speleoalex/opsdatalogger/README.md

# FluxyLogger

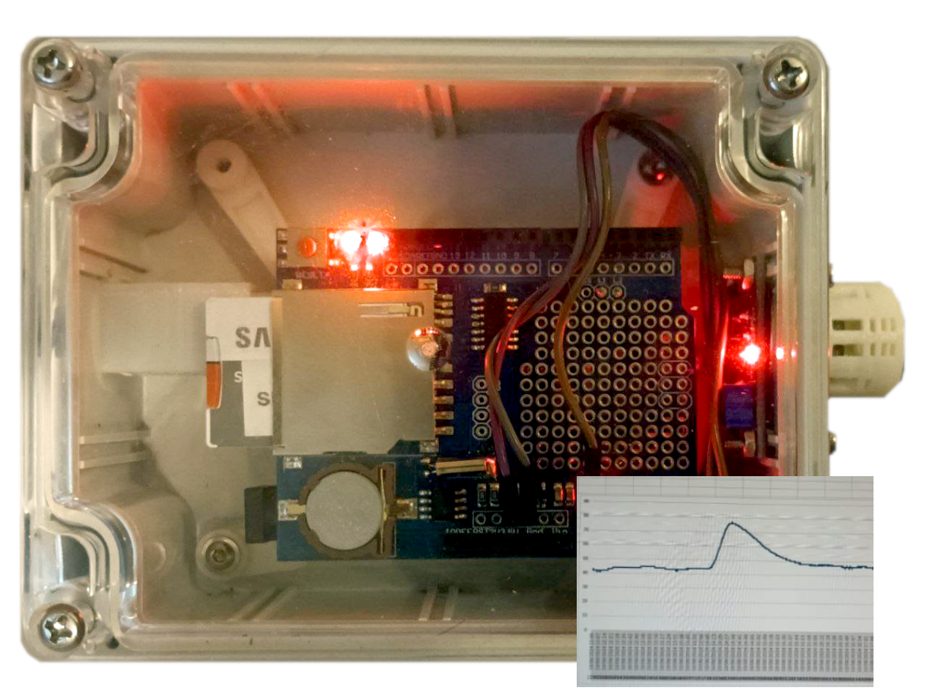
[picture p1: Naso.png]
FluxyLogger


**FluxyLogger** is an open source modular datalogger platform based on Arduino UNO for environmental monitoring, originally developed for cave air tracing studies.

## 🎯 Quick Start

**New here?** Start with the Platform Overview to understand available configurations:

- 📘 [**Platform Overview (English)**](FluxyLogger-Platform-Overview-en.md)
- 📘 [**Panoramica Piattaforma (Italiano)**](FluxyLogger-Platform-Overview-it.md)

## 📦 Available Configurations

FluxyLogger can be configured for different applications:

| Configuration | Sensors | Use Case | Status | Documentation |
|---|---|---|---|---|
| 🌬️ **NASO** | MQ-2 | Air tracing in caves | ✅ Ready | [IT](manuals/FluxyLogger-NASO-it.md) \| [EN](manuals/FluxyLogger-NASO-en.md) |
| 📱 **NASO + LCD** | MQ-2 + Display | Air tracing with real-time display | ✅ Ready | [IT](manuals/FluxyLogger-NASO_lcd-it.md) \| [EN](manuals/FluxyLogger-NASO_lcd-en.md) |
| 🌤️ **METEO** | BMP280 + Anemometer | Weather station (pressure, temp, wind) | ✅ Firmware ready | [IT](doc/assembly/METEO_VOC_assembly_guide_it.md) \| [EN](doc/assembly/METEO_VOC_assembly_guide_en.md) |
| 🏭 **VOC** | SGP40/SGP30 | Air quality monitoring (VOC index) | ✅ Firmware ready | [IT](doc/assembly/METEO_VOC_assembly_guide_it.md) \| [EN](doc/assembly/METEO_VOC_assembly_guide_en.md) |

**Note**: METEO and VOC firmware support is complete (v2.45) but requires enabling sensors in code - see assembly guides for details.

**Purchase**: Assembled NASO units available at [TechMakers](https://techmakers.eu/products/new-cave-monitoring-n-a-s-o-datalogger-for-atmospheric-tracer-tracking-assembled)

## 🔧 Base Components

All configurations share:

- Arduino UNO (or WiFi R4)
- Data Logger Shield with RTC
- MicroSD Card
- USB PowerBank
- Enclosure box
- Connection wires

[Full component list](doc/components.md)

## 📖 Documentation

### User Guides

- [Platform Overview IT](FluxyLogger-Platform-Overview-it.md) - Panoramica completa delle configurazioni
- [Platform Overview EN](FluxyLogger-Platform-Overview-en.md) - Complete configuration overview
- [NASO Manual IT](manuals/FluxyLogger-NASO-it.md) - Manuale utente configurazione NASO
- [NASO Manual EN](manuals/FluxyLogger-NASO-en.md) - NASO configuration user manual
- [Update Firmware IT](manuals/UpdateFirmware_it.md) - Aggiornamento firmware
- [Project History IT](Progetto_Fluxylogger_NASO.md) - Storia del progetto

### Assembly Guides

- [NASO Assembly IT](doc/assembly/NASO_assembly_complete_guide_it.md) - Guida assemblaggio NASO e NASO+LCD
- [NASO Assembly EN](doc/assembly/NASO_assembly_complete_guide_en.md) - NASO and NASO+LCD assembly guide
- [METEO/VOC Assembly IT](doc/assembly/METEO_VOC_assembly_guide_it.md) - Guida assemblaggio METEO e VOC
- [METEO/VOC Assembly EN](doc/assembly/METEO_VOC_assembly_guide_en.md) - METEO and VOC assembly guide

### Technical Documentation

- [Wiring Diagrams](doc/wiring/) - Connection schematics for all sensors
- [Source Code](FluxyLogger/FluxyLogger.ino) - Arduino firmware (v2.45)
- [CAD Files](drawings/) - 3D models and enclosure drawings
- [Technical Docs](doc/) - Datasheets, presentations, and technical resources

### Software Tools

- [LoggerViewer Web App](https://applications.techmakers.it/datalogger/loggermanager.htm) - Browser-based data viewer
- [LoggerViewer Desktop](LoggerViewer_Desktop/README.md) - Cross-platform desktop application
- [AI Assistant](https://www.sparkilla.com/application/NASO4CAVE) - Virtual assistant for log analysis

## 💾 Data Format

All configurations save data to microSD as CSV files with timestamps:

**NASO (Gas Detection):**

```csv
date Y-m-d H:M:S;gas adc;LPG PPM
2023-11-17 17:16:02;80;0
2023-11-17 17:17:02;125;45
```

**METEO (Weather Station):**

```csv
date Y-m-d H:M:S;temperature_C;pressure_hPa;altitude_m;wind_speed_ms
2025-01-24 12:30:00;15.2;1013.5;450;2.3
```

**VOC (Air Quality):**

```csv
date Y-m-d H:M:S;voc_index;tvoc_ppb;temperature_C;humidity_RH
2025-01-24 12:30:00;125;450;22.5;55
```

Measurement interval configurable via CONFIG.INI or USB connection.

## 🌍 Community & Support

- **Telegram Group**: [https://t.me/+u5CoELQNjC1iODZk](https://t.me/+u5CoELQNjC1iODZk)
- **GitHub**: [https://github.com/speleoalex/fluxylogger](https://github.com/speleoalex/fluxylogger)
- **Issues**: Report bugs and request features on GitHub Issues

### Support the Project

If you find this project useful, consider supporting its development:

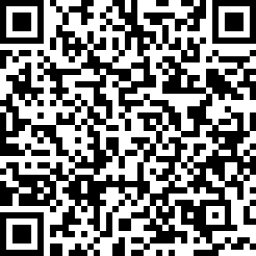
[picture p2: paypal.png]
Donate with PayPal (https://www.paypal.com/donate/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)


## 📜 License & Credits

- **License**: GNU General Public License
- **Author**: Alessandro Vernassa (speleoalex@gmail.com)
- **Website**: <https://techmakers.it/un-naso-per-gli-speleologi.html/>
- **Firmware Version**: 2.45
- **Started**: 2020

---

**Quick Links**: [Platform Overview](FluxyLogger-Platform-Overview-en.md) | [NASO Manual](manuals/FluxyLogger-NASO-en.md) | [Firmware Update](manuals/UpdateFirmware_it.md) | [Components](doc/components.md)
