speleoalex/opsdatalogger/doc/README.md

# Technical Documentation

Documentazione tecnica del progetto FluxyLogger.

## Struttura Directory

### 📁 [datasheets/](datasheets/)
Datasheet e manuali tecnici dei componenti:
- Sensori (MQ-2, MQ-6, SGP40, BMP280)
- Moduli e shield
- Documentazione in PDF

### 📁 [wiring/](wiring/)
Schemi di collegamento elettrico:
- `connections_MQ2_NASO.png` - Schema MQ-2
- `connections_lcd.png` - Schema LCD I2C
- `connections_LCD_LCM1602_I2C_version.png` - Schema LCD alternativo
- `connections_bmp280.png` - Schema BMP280
- `connections_sgp40.png` - Schema SGP40
- `connections_wind.png` - Schema Wind Sensor

### 📁 [assembly/](assembly/)

Assembly and testing guides:

**Italian (IT):**

- [NASO_assembly_complete_guide_it.md](assembly/NASO_assembly_complete_guide_it.md) - Complete NASO and NASO+LCD assembly and testing guide
- [METEO_VOC_assembly_guide_it.md](assembly/METEO_VOC_assembly_guide_it.md) - METEO and VOC assembly and testing guide

**English (EN):**

- [NASO_assembly_complete_guide_en.md](assembly/NASO_assembly_complete_guide_en.md) - Complete NASO and NASO+LCD assembly and testing guide
- [METEO_VOC_assembly_guide_en.md](assembly/METEO_VOC_assembly_guide_en.md) - METEO and VOC assembly and testing guide

### 📁 [presentations/](presentations/)
Materiale di presentazione del progetto

### 📁 [tracers/](tracers/)
Documentazione sui traccianti atmosferici

## File nella Root

- `components.md` - Lista completa componenti hardware
- Immagini varie per documentazione

## Collegamenti Utili

- [Lista Componenti](components.md)
- [Schemi CAD](../drawings/)
- [Manuali Utente](../manuals/)
