speleoalex/opsdatalogger/example_logs/log_Finale_Ligure_Perti/2025_06_29_giugno_Pollera/Relazione_NASO_Pollera_29_giugno_2025.pdf

# Tracciamento 29 giugno 2025 Arma della Pollera

Il 28 giugno, alle ore 13:45, abbiamo effettuato un tracciamento utilizzando quattro bombolette di aria compressa da 400 ml, immesse sul fondo dello scivolo della grotta Pollera.
La temperatura esterna era di 30 gradi.
I sensori N.A.S.O. sono stati posizionati all’ingresso dell’Arma della Pollera, uno a destra e uno a sinistra dello scivolo, nonché nell’Arma do Rian, sia prima che dopo la strettoia e all’Arma della Puzzanghera a circa metà grotta..
Non è stato possibile disporre di termometri per rilevare la temperatura interna.

## Risultati tracciamento

Grotta del Rian interno:
Positivo dalle 14:20 con picco 18:33

Grotta del Rian esterno:
Positivo dalle 14:50 con picco 18:33

Garbu du Surdu
Positivo dalle 15:20 con picco alle 22:09

Arma della Pozzanghera
Negativo

## Grafici

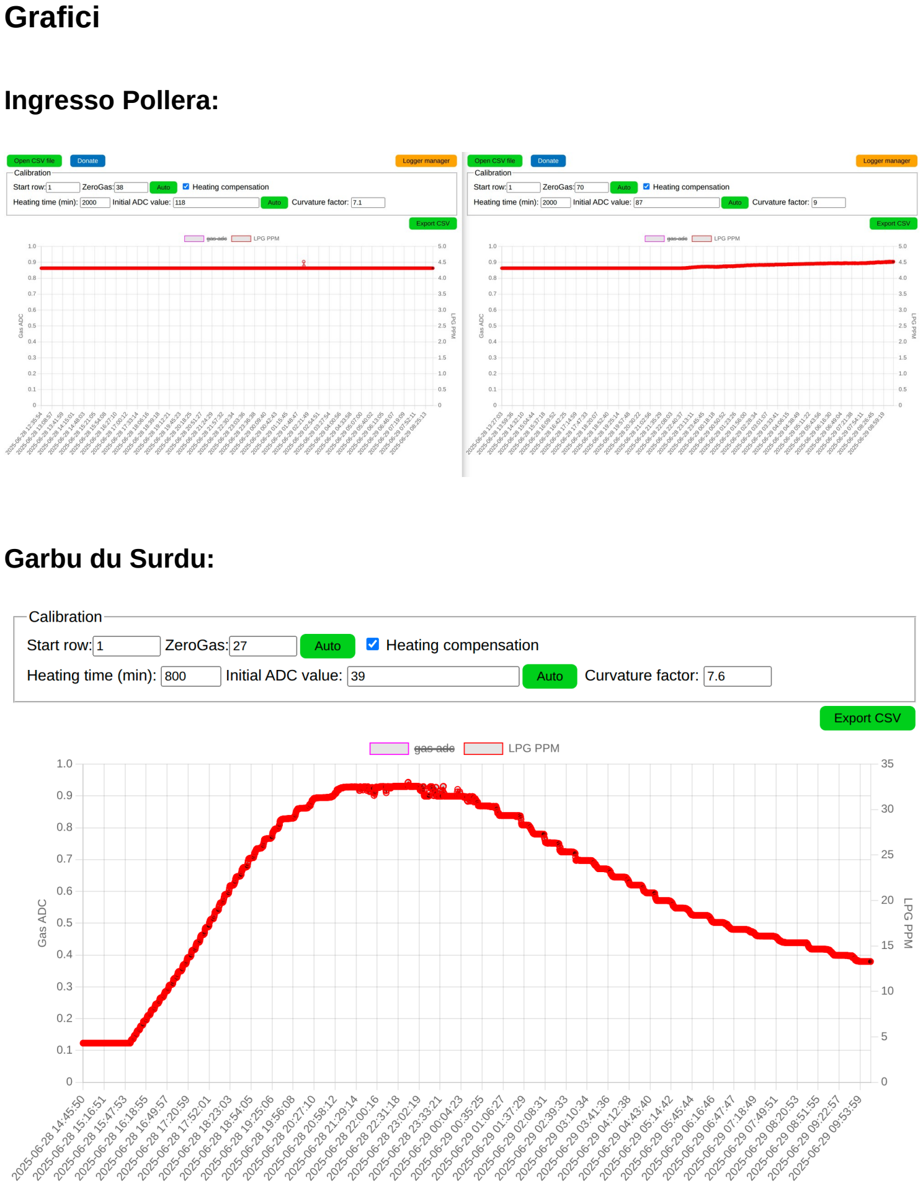
[picture p7: page 2]

Ingresso Pollera:

Garbu du Surdu:

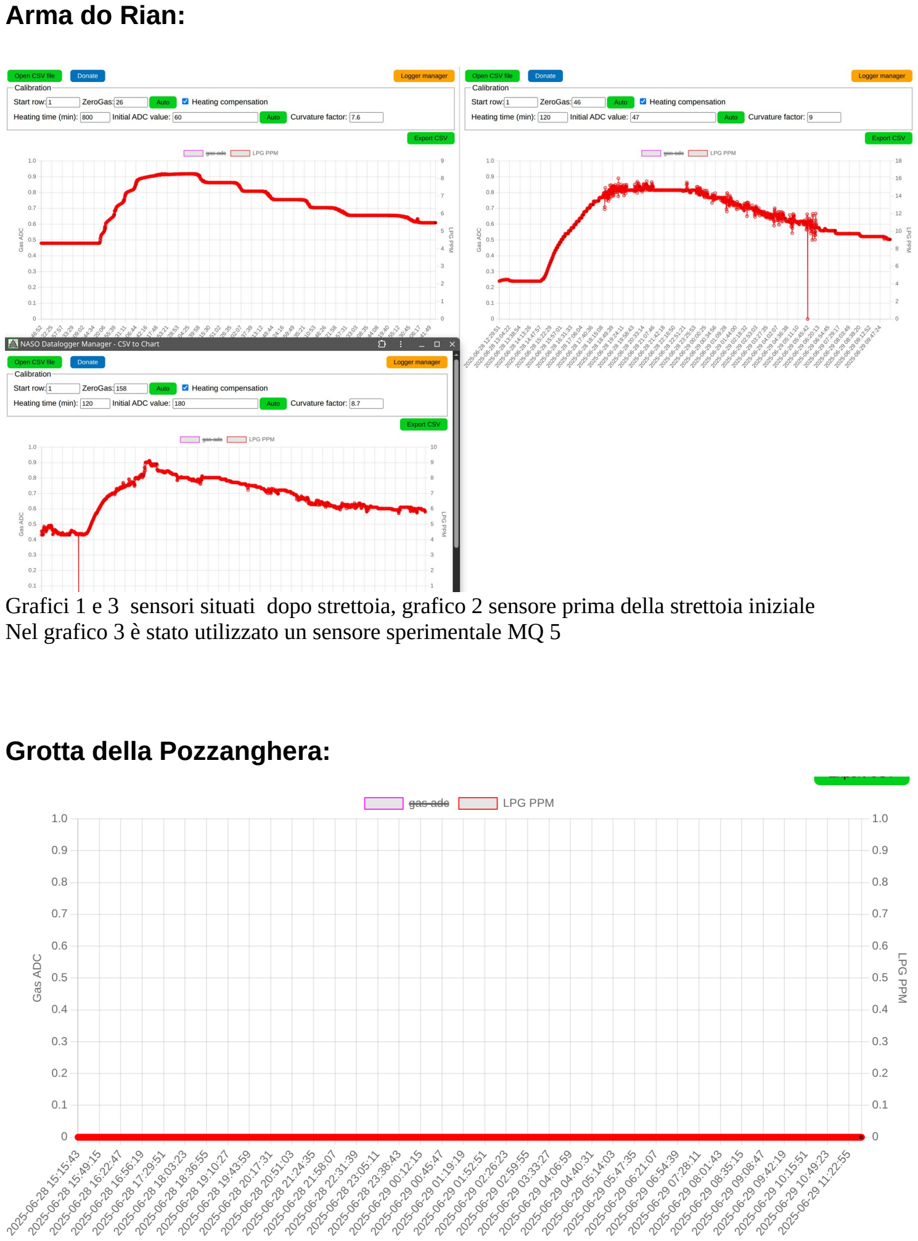
[picture p8: page 3]

Arma do Rian:

Grafici 1 e 3 sensori situati dopo strettoia, grafico 2 sensore prima della strettoia iniziale Nel grafico 3 è stato utilizzato un sensore sperimentale MQ 5

Grotta della Pozzanghera:
