speleoalex/opsdatalogger/doc/tracers/Tracer_dispersion_IT.md

# Dispersione di traccianti artificiali in grotte ventilate

**Autori:** Claudio Pastore, Eric Weber, Frédéric Doumenc, Pierre-Yves Jeannin, Marc Luetscher

**Pubblicato su:** International Journal of Speleology, 53(1), 51-62, Gennaio 2024

**DOI:** https://doi.org/10.5038/1827-806X.53.1.2497

---

## Abstract

La CO2 artificiale è stata utilizzata come tracciante lungo condotti carsici ventilati per dedurre il flusso d'aria e investigare la dispersione del tracciante. Nella zona vadosa carsica, la ventilazione delle grotte è un modo efficiente di trasporto per calore, gas e aerosol e quindi guida la distribuzione spaziale delle particelle trasportate dall'aria. La modellizzazione di questo trasporto aereo richiede parametri geometrici e fisici del sistema di condotti, incluse le sezioni trasversali, il flusso d'aria e la velocità media dell'aria, così come il coefficiente di dispersione longitudinale che descrive la diffusione di un soluto.

Quattro test di tracciamento sono stati effettuati in una miniera (condotto artificiale) e due grotte ventilate (condotti naturali). In questo articolo, dimostriamo che è possibile ottenere tassi di flusso d'aria affidabili e informazioni geometriche di condotti carsici ventilati utilizzando la CO2 come tracciante. Il flusso d'aria è stato misurato lungo due grotte e una miniera e confrontato con misurazioni puntuali effettuate con un anemometro a filo caldo. Le sezioni trasversali stimate con i test di CO2 sono state confrontate con quelle misurate in situ.

Inoltre, l'analisi delle curve di breakthrough (BTC) ha mostrato un accentuato effetto coda lungo i condotti naturali investigati a causa della presenza di singolarità dispersive che possibilmente permettono la deposizione di aerosol. La lunga coda osservata nelle grotte di Milandre e Longeaigue è probabilmente dovuta a variazioni di sezione trasversale. Un modello di avvezione-dispersione 1-D testato per questi siti non è stato in grado di adattarsi all'effetto coda delle BTC nei condotti naturali.

Nel condotto artificiale di Baulmes, dove non si osserva una lunga coda, il coefficiente di dispersione è stato stimato utilizzando il metodo di Chatwin e confrontato con la previsione della teoria di Taylor. Nonostante la geometria regolare della miniera di Baulmes, la correlazione di Taylor sottostima significativamente il coefficiente di dispersione dedotto dai dati di campo, mostrando la necessità di ulteriori lavori teorici sulla dispersione turbolenta nelle miniere.

Questo articolo fornisce una prima panoramica sul movimento dell'aria e sulla dispersione della materia lungo condotti carsici ventilati, preparando una corretta modellizzazione della dispersione degli aerosol.

**Parole chiave:** ventilazione carsica, effetto camino, flusso d'aria, CO2, test di tracciamento

---

## 1. INTRODUZIONE

Nella zona vadosa carsica, la ventilazione delle grotte è un modo efficiente di trasporto per calore, gas e aerosol e quindi guida la distribuzione spaziale delle particelle trasportate dall'aria. La modellizzazione di questo trasporto aereo richiede parametri geometrici e fisici del sistema di condotti, incluse le sezioni trasversali, il flusso d'aria e la velocità media dell'aria, così come i processi di dispersione che descrivono la diffusione della sostanza trasportata.

I parametri geometrici e la velocità dell'aria possono talvolta essere misurati sul campo, ma le imprecisioni derivano da misurazioni puntuali che possono riflettere male la velocità media dell'aria lungo i condotti. Anche il dimensionamento delle sezioni trasversali è soggetto ad approssimazioni quando estratto da un rilievo di grotta. Pertanto, sarebbe auspicabile un metodo che possa fornire informazioni sulla geometria del condotto in modo sicuro, economico e affidabile.

Il tracciamento dell'aria è stato ampiamente utilizzato nell'ingegneria mineraria per dedurre il trasporto di polvere e contaminanti nel tempo e nello spazio lungo i canali per prevenire danni alla salute degli operatori minerari dal rilascio di fumo e fumi di miniera. Tuttavia, è stato applicato solo raramente alla dinamica dell'aria nei sistemi naturali di grotte che differiscono dalle miniere a causa delle loro morfologie più complesse.

La letteratura speleologica sul tracciamento dell'aria in grotta è scarsa sebbene siano stati riportati diversi tentativi, ad esempio con CO2 iniettata, SF6 e CCl2F2, così come utilizzando traccianti naturali o flusso d'aria indotto artificialmente. La maggior parte degli studi mirava a ottenere informazioni su ingressi/uscite d'aria o tassi di flusso d'aria, ma nessuno di questi ha tentato di derivare informazioni geometriche sulla rete di condotti né la dispersione del tracciante lungo condotti naturali.

In questo articolo, dimostriamo che è possibile ottenere tassi di flusso d'aria affidabili e informazioni geometriche utilizzando la CO2 come tracciante aereo. Come per gli studi idro(geo)logici, i tassi di flusso e i parametri geometrici dei condotti possono essere derivati dalle informazioni fornite dalla curva di breakthrough (BTC) del tracciante. Inoltre, dimostriamo che nella geometria abbastanza regolare di una miniera, è possibile valutare il coefficiente di dispersione D utilizzando il metodo di Chatwin, comunemente usato in idrogeologia. Infine, suggeriamo che la coda osservata con CO2 nelle grotte con geometria complessa potrebbe essere causata dalle stesse singolarità che causerebbero la deposizione di aerosol.

---

## 2. METODI

### 2.1 Descrizione dei Siti

Quattro test di tracciamento con CO2 sono stati effettuati in una miniera ventilata naturalmente (condotto artificiale, Miniera di Baulmes) e due grotte ventilate (condotti naturali, grotte di Milandre e Longeaigue). Questi condotti sono soggetti a un effetto camino e tre dei quattro test sono stati effettuati durante un regime di ventilazione ascendente (con Tsistema > Test), mentre uno è stato eseguito durante un regime di ventilazione discendente (Tsistema < Test).

#### Miniera di Baulmes

La Miniera di Baulmes (46°47'33'' N 6°31'35'' E, 655 m s.l.m.) è stata sfruttata durante la prima metà del XX secolo per la produzione di calce e cemento. La miniera inferiore comprende 7 livelli sub-orizzontali con una lunghezza cumulata di circa 10,7 km. La differenza di elevazione tra gli ingressi inferiore e superiore raggiunge 90 m, garantendo un forte effetto camino.

Il Tunnel #10 dà accesso al livello più basso della miniera con un condotto sub-orizzontale lungo 360 m che raggiunge la rete principale della miniera. La geometria è tipica di un tunnel minerario: terreno piatto (eccetto alcuni crolli locali), pareti verticali e un soffitto a volta a botte. Non si osservano ingressi o uscite d'aria lungo il Tunnel #10, eccetto per l'ingresso principale.

Tre data logger di CO2 sono stati posizionati a diverse stazioni: per il test durante il regime ascendente a 128 m (St_B3), 280 m (St_B4) e 360 m (St_B5) dall'ingresso inferiore; a 232 m (St_B3), 270 m (St_B2) e 360 m (St_B1) per il test durante il regime discendente.

#### Grotta di Milandre

La Grotta di Milandre (47°29'6'' N 7°0'58'' E, 402 m s.l.m.), lunga 10,5 km, si trova nella Svizzera settentrionale su un altopiano calcareo a un'elevazione di circa 500 m s.l.m. I principali passaggi del fiume sotterraneo cumulano 4,6 km tra gli ingressi superiore e inferiore (135 m di differenza di elevazione). La grotta è conforme all'effetto camino, garantendo una ventilazione permanente (discendente o ascendente, a seconda della temperatura esterna).

Il test di tracciamento con CO2 è stato effettuato in un transetto lungo 90 m nella parte inferiore della grotta. Due stazioni di misurazione sono state posizionate rispettivamente a 20 m (Mil_20) e 90 m (Mil_90 m) dal punto di rilascio della CO2.

#### Grotta di Longeaigue

La Grotta di Longeaigue si trova in Val-de-Travers (Ingresso superiore: 46°52′22″ N 6°31′09″ E, 917 m s.l.m.; Ingresso inferiore: 46°52′18″ N 6°31′09″ E, 820 m s.l.m.) e si sviluppa per 1,3 km. È principalmente asciutta ed è attraversata da un intenso flusso d'aria dovuto all'effetto camino che si sviluppa tra i due ingressi. La differenza di elevazione è di 90 m con una distanza di ~300 m tra i due ingressi.

Il test di CO2 è stato effettuato lungo il passaggio principale, rilasciando il gas vicino all'ingresso inferiore e monitorando il breakthrough del gas a 3 stazioni: Lo_239 (239 m dal punto di iniezione), Lo_278 (278 m dal punto di iniezione) e Lo_294 (294 m dal punto di iniezione).

La grotta è abbastanza grande fino a ~237 m, con estese gallerie sub-orizzontali freatiche che mostrano alcune morfologie di rimodellamento vadoso (pozzi), e diventa più stretta nella parte superiore dove la grotta ha condotti di compressione. Tra le stazioni Lo_294 e Lo_278 è presente un passaggio secondario della grotta che può causare cadute di flusso d'aria in questa sezione della grotta.

### 2.2 Confronto tra i Tre Siti

Sono state rilevate ventotto sezioni trasversali a Baulmes, 10 a Milandre e 30 a Longeaigue. Per tutti tranne i primi 50 metri, la forma del tunnel di Baulmes è abbastanza omogenea, mostrando una bassa deviazione standard. Nei primi 128 m del tunnel, la media della sezione trasversale è 6,4 ± 1,8 m² (n = 13) e dall'ingresso alla seconda stazione a 280 m è 6,3 ± 1,3 m² (n = 29). Lungo l'intero tunnel di 360 m la sezione trasversale media è 6,6 ± 1,4 m² (n = 37).

Nella Grotta di Milandre, la media della sezione trasversale dei primi 20 m (Mil_20) è 10,8 ± 6,6 m² (n = 3), mentre l'intero condotto di 90 m (Mil_90) ha una sezione trasversale media di 6,3 ± 4,9 m² (n = 10).

Nella Grotta di Longeaigue, la sezione trasversale media rilevata dal punto di iniezione alla prima stazione (Lo_239) è 7,4 m² ± 4,2 (n = 25), alla seconda stazione (Lo_278) di 7,0 ± 4,3 m² (n = 27) e all'ultima stazione (Lo_294) di 6,7 ± 4,3 m² (n = 29).

La deviazione standard delle sezioni trasversali medie rende possibile affermare che i condotti naturali di Longeaigue e Milandre hanno una distribuzione meno uniforme delle sezioni trasversali su una distanza minore rispetto al tunnel antropico di Baulmes e che le variazioni di sezione trasversale in Baulmes sono meno pronunciate che in Longeaigue e Milandre.

### 2.3 Strumentazione

È stato utilizzato un serbatoio di 1,5 kg di CO2 (2 L, 5,7·10³ kPa) per rilasciare il tracciante. Il serbatoio era dotato di una valvola a rubinetto. Per garantire che trilascio < ttransito è stato aperto per 1-2 minuti (a seconda della distanza di percorrenza). La massa di CO2 rilasciata (±0,05 kg) è stata ottenuta pesando il serbatoio prima e dopo ogni test.

La CO2 è stata monitorata a intervalli di tempo di 1 min a Baulmes e 20 sec a Milandre e Longeaigue, utilizzando sensori di CO2 SCD-41 (Adafruit; precisione del dispositivo ±50 ppmv +5% della lettura) implementati su un microcontrollore da 3,3 V basato su protocollo I2C, funzionante come data logger. L'errore sulle concentrazioni misurate è generalmente tra il 10% e il 15%.

È stato utilizzato un anemometro a filo caldo portatile (Testo 425; precisione del dispositivo ±0,03 m/s +5% della lettura) per misurare il flusso nei condotti mediante integrazione di 6 misurazioni mediate su 30 s in ciascuna sezione trasversale. I risultati sono confrontati con il flusso d'aria dedotto dal tracciamento con CO2, assunto costante durante i test.

### 2.4 Approcci Teorici

#### Tracciamento del Flusso d'Aria

Gli esperimenti di tracciamento si basano sulla dispersione e sulla conservazione della massa di un tracciante artificiale in un flusso di fluido. Il tasso di flusso d'aria può essere derivato dall'equazione:

**Q = m / ∫ c(t) dt**

dove Q è il tasso di flusso d'aria [m³/s], m è la massa nota del tracciante iniettato [g], c è la concentrazione misurata [ppmv] al tempo t [s].

È importante notare che questa equazione fornisce una stima accurata del tasso di flusso Q se viene soddisfatta la conservazione della massa, cioè se non ci sono perdite tra il punto di iniezione e il sensore.

La velocità media dell'aria U e l'area media della sezione trasversale A possono essere determinate da un'analisi quantitativa delle BTC. La velocità media del tracciante (Up) si ottiene dividendo la distanza di percorrenza per il tempo al picco della BTC (valore massimo):

**Up = L / tpicco**

Il tempo di residenza medio t̄ [s], ovvero il tempo richiesto per la massa del tracciante di attraversare l'intera lunghezza L [m], per un rilascio di impulso breve è dato da:

**t̄ = ∫ t C(t) Q(t) dt / ∫ C(t) Q(t) dt**

Per un tasso di flusso costante Q, il volume V [m³] di aria che attraversa l'intera lunghezza L durante il test è dato da:

**V = Q t̄**

e la sezione trasversale media A [m²] lungo la lunghezza L è data da:

**A = V / L**

---

## 3. RISULTATI

### 3.1 Curve di Breakthrough della CO2

Le curve di breakthrough (BTC) misurate all'ultima stazione di ciascun sito mostrano forme diverse. Per il test di Baulmes, i punti sono distribuiti abbastanza simmetricamente attorno a t* ≡ t/tpicco = 1. Invece, le BTC delle grotte mostrano una forma più asimmetrica, con una parte significativa della distribuzione inclusa nell'intervallo di tempo da t* = 1,5 a 2,5.

Poiché la temperatura esterna non è variata significativamente durante i test, si presume che il flusso d'aria interno sia costante e le code estese probabilmente risultano dalla geometria più irregolare delle grotte rispetto al condotto artificiale di Baulmes. Nel caso della Grotta di Milandre, la concentrazione di fondo non è stata completamente recuperata perché la CO2 è stata rilasciata in una camera favorendo la coda dovuta alla ricircolazione d'aria e alla diffusione.

### 3.2 Tasso di Flusso d'Aria e Geometria del Condotto

Per dedurre il flusso d'aria, si presume la conservazione della massa del tracciante per tutti i test. I risultati tra il flusso d'aria misurato e quello misurato direttamente mostrano che la deviazione relativa tra il flusso d'aria misurato con CO2 e le misurazioni dirette rimane costantemente al di sotto del 5% a Baulmes. Tuttavia, questa differenza si espande a circa il 30% a Milandre e può arrivare fino al 47% all'ultima sonda di Longeaigue, tra Lo_294 e Lo_278.

Dalle analisi delle BTC, è stato possibile dedurre le sezioni trasversali medie (ACO2) alle stazioni di misura. Le differenze tra Aavg e ACO2 nella Miniera di Baulmes erano comprese tra l'1,5% e il 3,2%, mostrando un buon accordo tra le sezioni trasversali dedotte e rilevate per entrambi i regimi di ventilazione.

Nella Grotta di Milandre il disaccordo tra i due metodi è stato maggiore. La sezione trasversale media valutata dal tracciamento con CO2 lungo il condotto lungo 90 m a Milandre (Mil_90) è più piccola di quella rilevata del 20%. Tuttavia, rientra nella variabilità di questo transetto della grotta (dev. st. ±4,9 m²).

Infine, le sezioni trasversali tracciate a Longeaigue mostrano differenze fino al 74% (Lo_294) rispetto a quelle ottenute dal rilievo in situ. Sebbene anche a Longeaigue la differenza relativa tra i due metodi sia all'interno della variabilità delle sezioni trasversali rilevate, l'accordo tra Aavg e ACO2 è notevolmente peggiore rispetto a quello di Milandre.

### 3.3 Analisi dei Dati: Coefficiente di Dispersione D e Simulazioni delle Curve

U e D sono stati adattati utilizzando il metodo geometrico di Chatwin. A Milandre e Longeaigue, il modello non può riprodurre l'ultima parte dei set di dati dove la coda è accentuata. Pertanto, questa parte delle curve non è stata considerata nell'adattamento. Al contrario, i set di dati completi di Baulmes sono stati presi in considerazione. In tutti i casi, è stata ottenuta un'alta correlazione tra i dati selezionati e le linee di adattamento (R² ≥ 0,97).

Come previsto dall'adattamento di U e D, le BTC simulate corrispondono sempre bene ai dati empirici di Baulmes, mentre la simulazione non riproduce l'ultima parte delle BTC a Longeaigue e Milandre, dove la concentrazione diminuisce più lentamente rispetto a un modello esponenziale.

Discutere i coefficienti di dispersione ottenuti a Milandre e Longeaigue non ha senso, poiché sono stimati utilizzando un'equazione che non riesce a descrivere le BTC. Il coefficiente di dispersione D a Baulmes è dell'ordine di 1 m²/s. È leggermente più grande per il flusso discendente, il che è coerente con la maggiore velocità dell'aria durante questo test.

---

## 4. DISCUSSIONE

Quattro test con CO2 sono stati effettuati in una miniera (condotto artificiale) e due grotte ventilate (condotti naturali), per investigare l'affidabilità del metodo per misurare il flusso d'aria, valutare le sezioni trasversali medie e dedurre il valore di dispersione lungo condotti carsici ventilati.

I test di tracciamento sono stati coerenti con la maggior parte delle misurazioni indipendenti eseguite manualmente con un anemometro. La differenza tra il flusso d'aria misurato e le misurazioni manuali varia generalmente tra 0 e 33%. Un'eccezione è la stazione Lo_294 a Longeaigue, dove la differenza ha raggiunto il 47%.

### 4.1 Conservazione della Massa e Perdite

La prima possibile spiegazione potrebbe essere correlata alla differenza di 3 ore tra la misurazione manuale e il tempo di iniezione. Tuttavia, la differenza di temperatura tra la grotta e la temperatura esterna, che guida il flusso d'aria all'interno della grotta tramite un effetto camino, era maggiore al momento della misurazione manuale rispetto al tracciamento con CO2.

In alternativa, il flusso d'aria misurato manualmente potrebbe essere stato influenzato dalla presenza dell'operatore nel condotto stretto di 0,5 m². Un altro possibile motivo per questa deviazione può essere correlato all'assunzione di conservazione della massa che potrebbe non essere corretta se il sistema in esame non è ben vincolato e conosciuto.

Se a Milandre e Baulmes l'assenza di divergenze d'aria è garantita, non è possibile dire lo stesso per Longeaigue. Come mostrato, la divergenza situata tra Lo_239 e Lo_294 potrebbe talvolta provocare un flusso d'aria secondario riducendo il flusso d'aria all'ingresso superiore. Sarà necessaria una maggiore investigazione per chiarire questo punto.

Per determinare il flusso d'aria, l'assunzione di base della conservazione della massa dell'aria deve essere verificata, altrimenti il flusso d'aria misurato potrebbe non essere affidabile. Tuttavia, la presenza di una perdita d'aria potrebbe essere verificata con la tecnica di tracciamento installando un logger lungo il possibile condotto di perdita, per confermare o meno il passaggio di CO2 iniettata. Pertanto, una buona conoscenza del sito studiato è fondamentale per assicurarsi che la conservazione della massa sia garantita.

### 4.2 Velocità dell'Aria e Sezioni Trasversali

La velocità dell'aria può essere riferita come velocità locale o come velocità media lungo un condotto. La prima può essere dedotta da misurazioni puntuali con anemometri, mentre la seconda richiede test di tracciamento e può essere rappresentata dalla velocità di picco della BTC (Up).

Nelle grotte, la velocità puntuale dell'aria è solitamente misurata in sezioni trasversali dove la corrente d'aria è sufficientemente forte da essere misurata, cioè in passaggi stretti. Pertanto, le misurazioni puntuali difficilmente forniranno una velocità media dell'aria sull'intera lunghezza della grotta.

Inoltre, si prevedono elevate incertezze a basse velocità dell'aria, come quando le sezioni trasversali sono grandi o in presenza di una piccola forza motrice (ad esempio, in grotte con una piccola distanza verticale tra gli ingressi o piccolo ΔT tra l'atmosfera esterna e interna). In particolare, a basse velocità, le misurazioni possono essere significativamente influenzate dalla precisione strumentale (ad esempio, precisione di ±0,03 m/s rispetto a misurazioni di 0,15 m/s) e richiederebbero un monitoraggio ad alta risoluzione con dispositivi digitali. Pertanto, il test di tracciamento con CO2 è un metodo affidabile per valutare il tasso di flusso d'aria in condizioni di bassa velocità.

La regolarità della galleria a Baulmes garantisce un risultato coerente tra le aree delle sezioni trasversali dedotte dalla CO2 e le sezioni minerarie rilevate, con una precisione strumentale sulla valutazione della sezione trasversale (ACO2) tra ±5% e ±7%.

Al contrario, nelle grotte di Milandre e Longeaigue, la differenza tra Aavg e ACO2 raggiunge il 20% e il 74%, rispettivamente. Sebbene le aree superficiali dedotte dai test di tracciamento con CO2 siano incluse nella variabilità naturale delle geometrie dei condotti, la discrepanza può essere dovuta a:

1. La stima del tempo di residenza medio del tracciante t̄
2. La bassa risoluzione spaziale (10 m) del rilievo in situ

A Longeaigue, cambiamenti improvvisi e sistematici di diametro, curve e divisione dell'aria sono presenti. Passaggi stretti con sezioni trasversali tra 0,5 e 1,1 m² sono stati rilevati in tutta la grotta, e le sezioni trasversali più grandi si trovano tra questi passaggi, costringendo l'aria a restringersi e espandersi continuamente, causando code e ritardi (alto t̄).

Le sezioni trasversali più grandi rallenteranno il trasporto diminuendo la velocità dell'aria, aumentando il tempo di residenza t̄. Un t̄ più alto si rifletterà in una sovrastima del volume medio del condotto e quindi in una sovrastima della sezione trasversale media del condotto. Di conseguenza, le zone di flusso morto e la ricircolazione dell'aria che causano la coda probabilmente portano a una migliore rappresentazione delle sezioni trasversali più grandi.

### 4.3 Confronto con la Teoria di Taylor

Per i test di Baulmes, è interessante confrontare i coefficienti di dispersione stimati dai dati di campo con la previsione della teoria di Taylor. Il numero di Reynolds Re = 4∙QCO2/p∙ν era dell'ordine di 10⁵ durante i test di Baulmes, indicando chiaramente un flusso d'aria turbolento.

La previsione di Taylor (1954) per il regime turbolento dice:

**DT = 5,05 d U***

dove la velocità di attrito U* è correlata alla velocità media Up dalla relazione:

**U* = Up √(f/8)**

dove f è il fattore di attrito di Darcy, che dipende da Re e dalla rugosità relativa εr = ε/d (con d = 4∙A/p il diametro idraulico del condotto). La rugosità assoluta della parete ε non è nota con precisione, ma stimiamo che dovrebbe essere nell'intervallo da 10 a 30 cm.

I nostri risultati rivelano che il coefficiente di dispersione D stimato dalle BTC di Baulmes è sistematicamente da 1,6 a 3,5 volte superiore alla previsione della teoria di Taylor. Le incertezze strumentali, che rappresentano ±15% di D, non possono spiegare queste discrepanze.

Una prima possibile spiegazione per la discrepanza tra il DT teorico e il D sperimentale potrebbe essere che il Tunnel #10 di Baulmes non è strettamente circolare, come assunto nella teoria di Taylor. Inoltre, la sezione della Miniera di Baulmes, sebbene molto più regolare delle grotte, varia significativamente lungo il condotto.

I nostri risultati sono comunque coerenti con quelli ottenuti da Widiatmojo et al. (2015), che hanno anche identificato una dispersione migliorata lungo i condotti minerari rispetto alle previsioni di Taylor. Questi autori hanno suggerito che gli alti coefficienti di dispersione misurati nella Miniera di Kushiro potrebbero essere correlati alla presenza di cavità lungo i tunnel della miniera, che intrappolano il tracciante e lo reintroducono nel flusso principale con un ritardo. L'assenza di tali cavità lungo il Tunnel #10 di Baulmes è coerente con un coefficiente di dispersione inferiore, più vicino alla teoria di Taylor.

### 4.4 Effetto Coda e Deposizione di Aerosol

L'analisi delle BTC ha mostrato una coda accentuata lungo i condotti naturali investigati a causa della presenza di singolarità dispersive che possibilmente permettono la deposizione di aerosol. La lunga coda osservata nelle grotte di Milandre e Longeaigue è probabilmente dovuta a variazioni di sezione trasversale, quindi le camere sono probabilmente soggette a deposizione.

In contrasto con le grotte di Longeaigue e Milandre, il modello di avvezione-dispersione 1-D riproduce correttamente la forma delle BTC nella Miniera di Baulmes. Tuttavia, la teoria di Taylor (1954) sottostima significativamente il coefficiente di dispersione dedotto dalle BTC.

Lungo le grotte naturali, le vie aeree incontrano curve, colli di bottiglia, crolli, rugosità variabile delle pareti, speleotemi e altri fattori strutturali che sono assenti nel condotto artificiale della Miniera di Baulmes. Questo è un punto chiave che probabilmente influenzerà il movimento dell'aria e di conseguenza la distribuzione e il deposito degli aerosol trasportati dall'aria.

Hauns et al. (2001) hanno evidenziato che il ritardo potrebbe risultare dalla presenza di strutture dispersive se queste hanno un tempo di stoccaggio dello stesso ordine di grandezza della durata della BTC del tracciante. Pertanto, la durata della coda consente una stima di quanto a lungo la materia può essere intrappolata in strutture a bassa velocità.

La legge di Stokes dice che le aree di flusso lento (zone di flusso morto) sono favorevoli alla deposizione di aerosol trasportati in un fluido (ad esempio aria). Le zone di flusso morto causano la deposizione di materia sospesa e la quantità di materia depositata è in qualche modo proporzionale alla durata della coda.

Pertanto, lungo i condotti carsici naturali, la geometria variabile e la presenza di ostacoli portano a zone di flusso morto. Queste zone di flusso morto (ad esempio, camere) ritardano il trasporto producendo code e modificano la dispersione con la distanza. Ad esempio, nel caso di Longeaigue, la coda suggerisce che le camere più grandi con una bassa velocità dell'aria sono più soggette a deposizione rispetto ai condotti ventilati più stretti.

---

## 5. CONCLUSIONI

Nella zona vadosa carsica, la ventilazione delle grotte è un modo efficiente di trasporto per calore e aerosol e guida la distribuzione spaziale delle particelle trasportate dall'aria in un sistema di grotte. La modellizzazione di questo trasporto aereo richiede parametri geometrici e fisici del sistema di condotti, incluse le aree delle sezioni trasversali, il flusso d'aria e la velocità media dell'aria, così come il coefficiente di dispersione che descrive la diffusione di un soluto.

I quattro esperimenti effettuati in condotti naturali e artificiali, utilizzando la CO2 come tracciante, hanno dimostrato di essere una tecnica adatta per dedurre il flusso d'aria e le sezioni trasversali medie dei condotti. Il valore di dispersione è stato anche dedotto applicando il metodo di Chatwin.

L'analisi delle BTC ha mostrato una coda accentuata lungo i condotti naturali investigati a causa della presenza di singolarità dispersive che possibilmente permettono la deposizione di aerosol. La lunga coda osservata nelle grotte di Milandre e Longeaigue è probabilmente dovuta a variazioni di sezione trasversale, quindi le camere sono probabilmente soggette a deposizione.

In contrasto con le grotte di Longeaigue e Milandre, il modello di avvezione-dispersione 1-D riproduce correttamente la forma delle BTC nella Miniera di Baulmes. Tuttavia, la teoria di Taylor (1954) sottostima significativamente il coefficiente di dispersione dedotto dalle BTC. Simulazioni numeriche delle equazioni di Navier-Stokes 3-D sarebbero interessanti per investigare la dispersione del soluto nelle grotte e nelle miniere, in particolare per valutare il ruolo della geometria del condotto.

Questo articolo fornisce una prima panoramica sul movimento dell'aria e sulla dispersione della materia lungo condotti carsici ventilati, preparando una corretta modellizzazione della dispersione degli aerosol.

---

## RILEVANZA PER IL PROGETTO FLUXYLOGGER NASO

Questo studio scientifico è rilevante per il progetto FluxyLogger NASO perché:

1. **Validazione della CO2 come tracciante**: L'articolo dimostra che la CO2 può essere utilizzata efficacemente come tracciante aereo in grotte ventilate, confermando l'approccio utilizzato nel progetto NASO per il monitoraggio dei flussi d'aria.

2. **Comprensione della dispersione**: Lo studio fornisce informazioni fondamentali su come i traccianti gassosi (come propano/butano usati nel NASO) si disperdono in condotti carsici con diverse morfologie.

3. **Effetto delle geometrie complesse**: I risultati mostrano che in grotte con geometrie complesse (simili a molti sistemi carsici naturali) si osserva un "effetto coda" nelle curve di breakthrough, importante per interpretare correttamente i dati del NASO.

4. **Metodologia di misura**: Le tecniche di analisi delle curve di breakthrough (BTC) descritte nell'articolo possono essere applicate per migliorare l'interpretazione dei dati raccolti dal FluxyLogger NASO.

5. **Deposizione di aerosol**: Lo studio evidenzia come le zone a basso flusso d'aria favoriscano la deposizione di aerosol, informazione cruciale per comprendere dove e come i traccianti si depositano durante gli esperimenti con il NASO.

---

**Documento originale:** Pastore, C., Weber, E., Doumenc, F., Jeannin, P.-Y., Luetscher, M., 2024. Dispersion of artificial tracers in ventilated caves. International Journal of Speleology, 53(1), 51-62.

**Traduzione a cura del progetto FluxyLogger - Gennaio 2025**
