speleoalex/opsdatalogger/doc/arduino_mq-2.jpeg

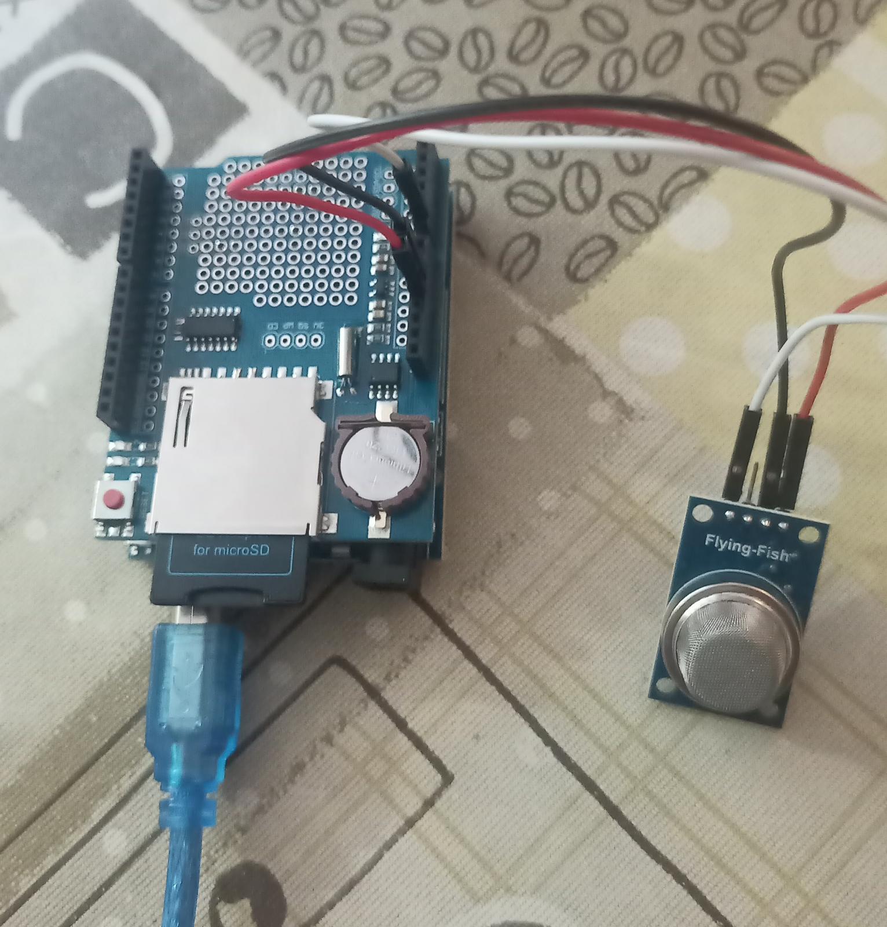
doc/arduino_mq-2.jpeg
