speleoalex/opsdatalogger/doc/datalogger.jpg

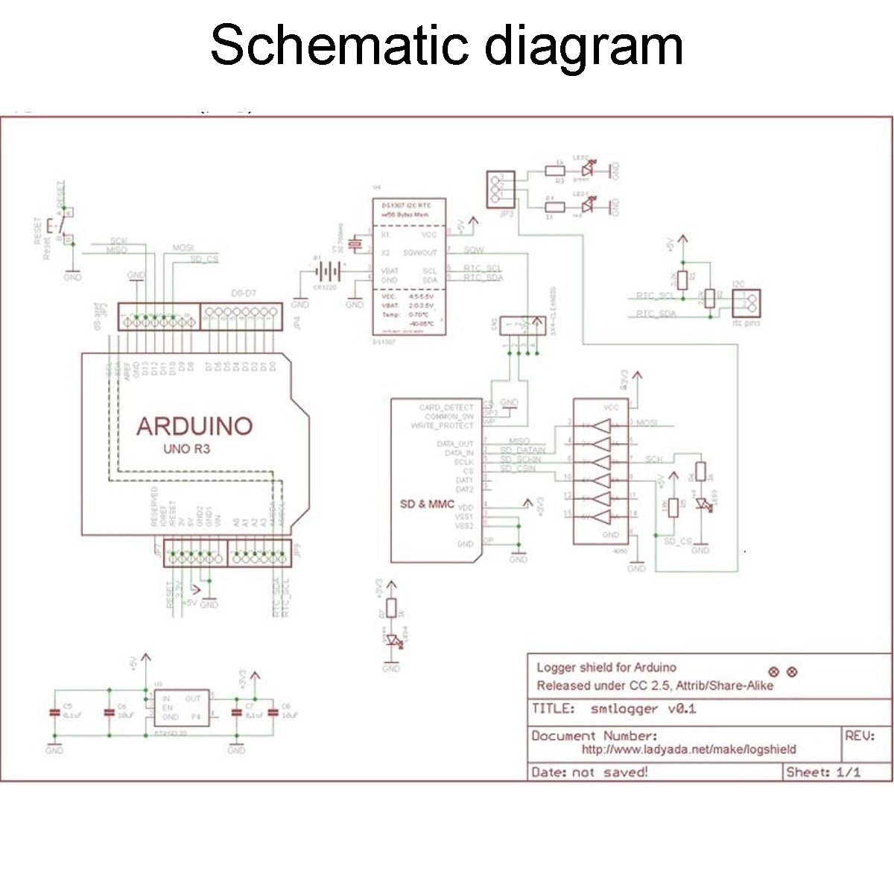
doc/datalogger.jpg
