speleoalex/opsdatalogger/doc/GasSensor.jpg

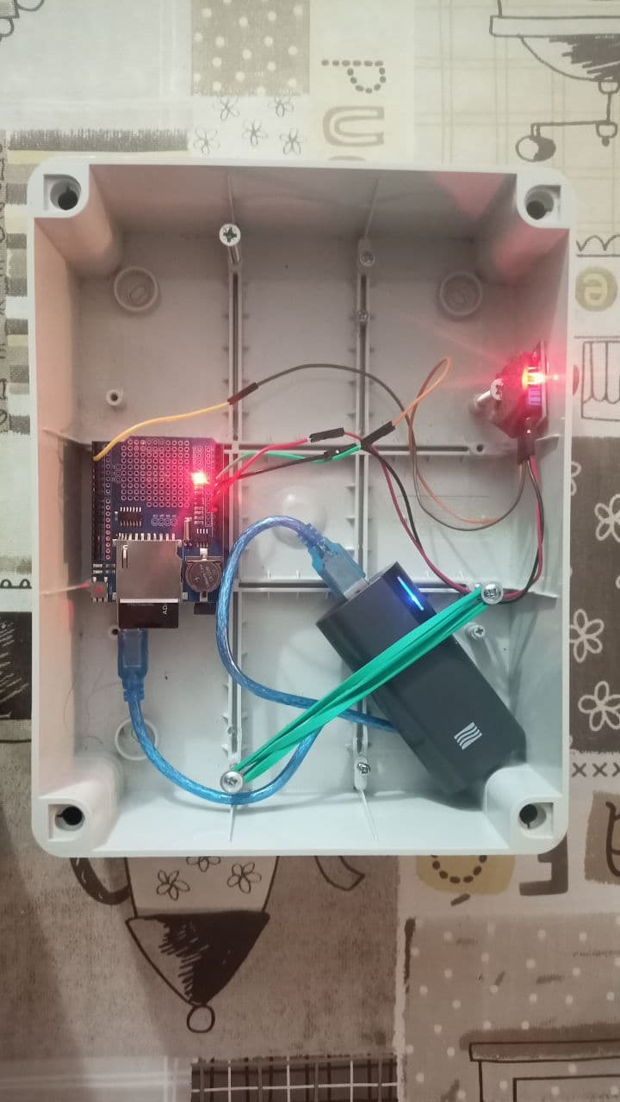
doc/GasSensor.jpg
