speleoalex/opsdatalogger/doc/LCD.jpeg

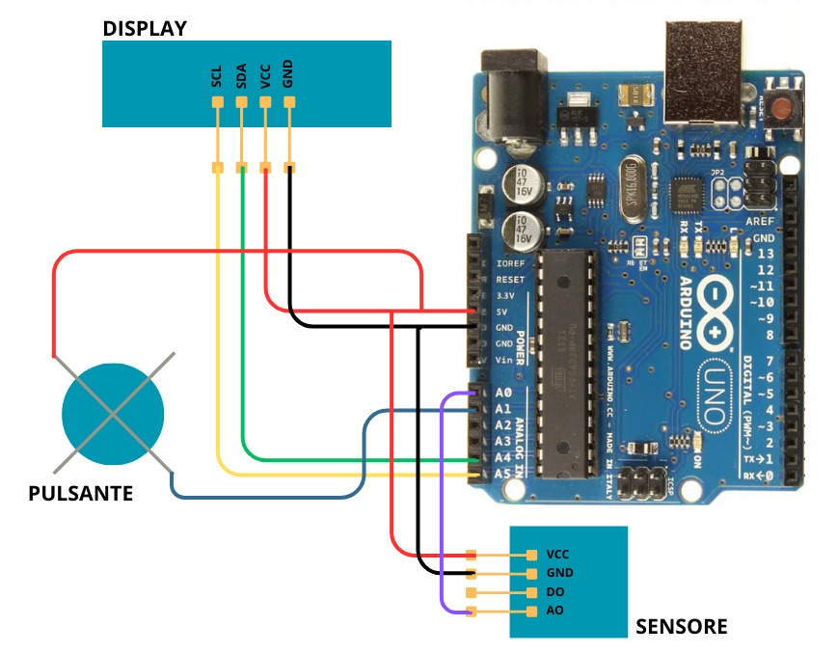
doc/LCD.jpeg
