speleoalex/opsdatalogger/example_logs/12/Screenshot_20250703_182815.png

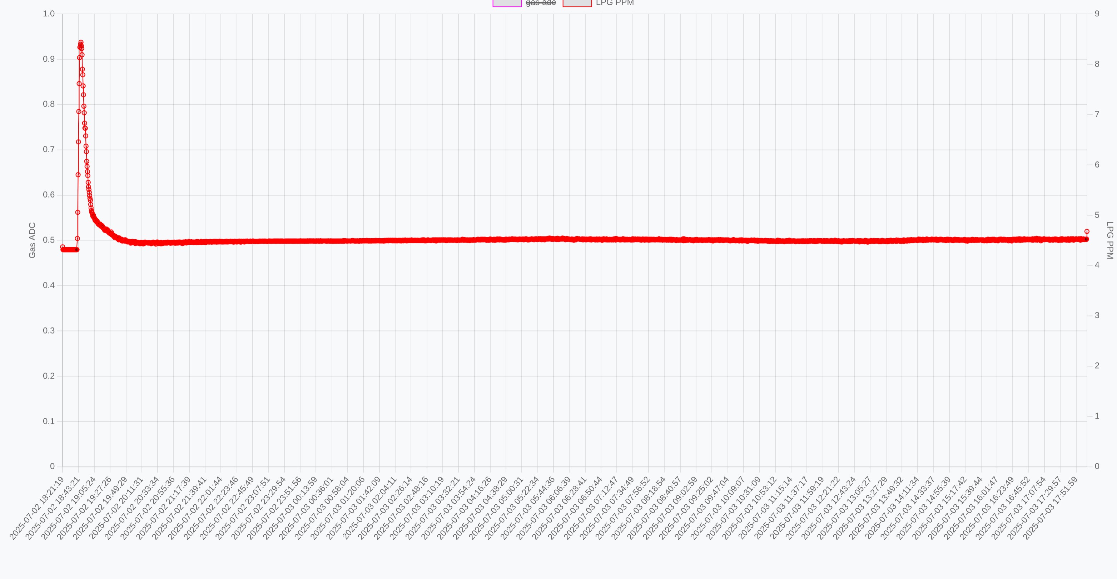
example_logs/12/Screenshot_20250703_182815.png
