speleoalex/opsdatalogger/example_logs/log_Finale_Ligure_Perti/2025_06_29_giugno_Pollera/Screenshot_20250629_131644.png

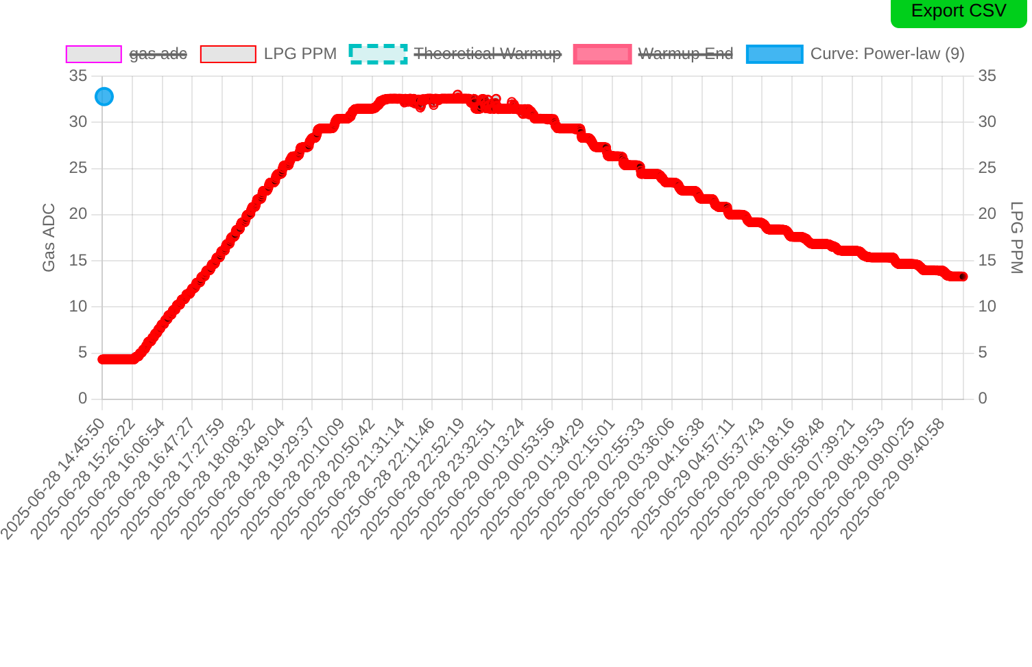
example_logs/log_Finale_Ligure_Perti/2025_06_29_giugno_Pollera/Screenshot_20250629_131644.png
