speleoalex/opsdatalogger/media/NASO_Liguria.jpeg

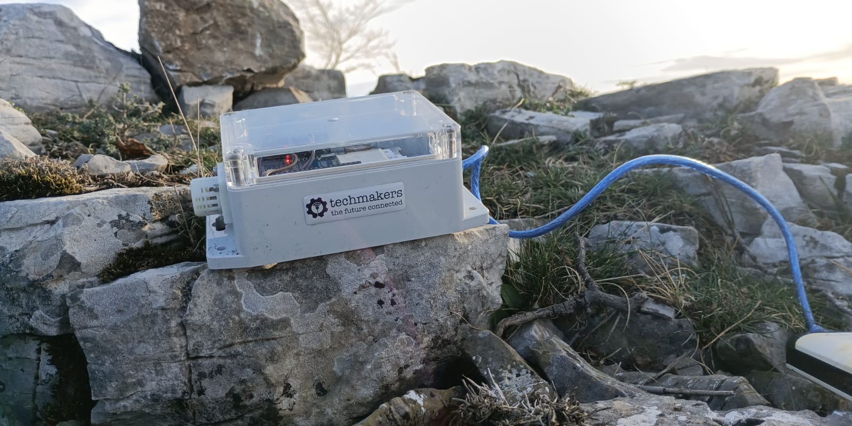
media/NASO_Liguria.jpeg
