speleoalex/opsdatalogger/drawings/Arduino UNO R3 shield - full.dxf

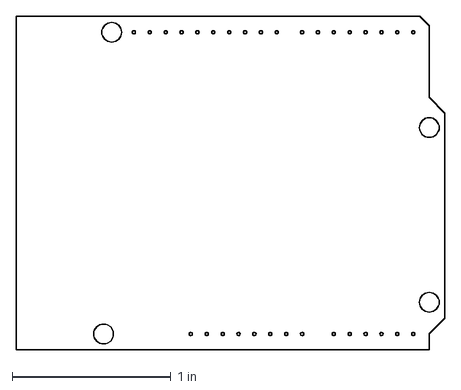
[picture p16: CAD file, 2025-06-17]
drawings/Arduino UNO R3 shield - full.dxf
2.70 x 2.10 in
