speleoalex/opsdatalogger/drawings/Arduino-UNO.stl

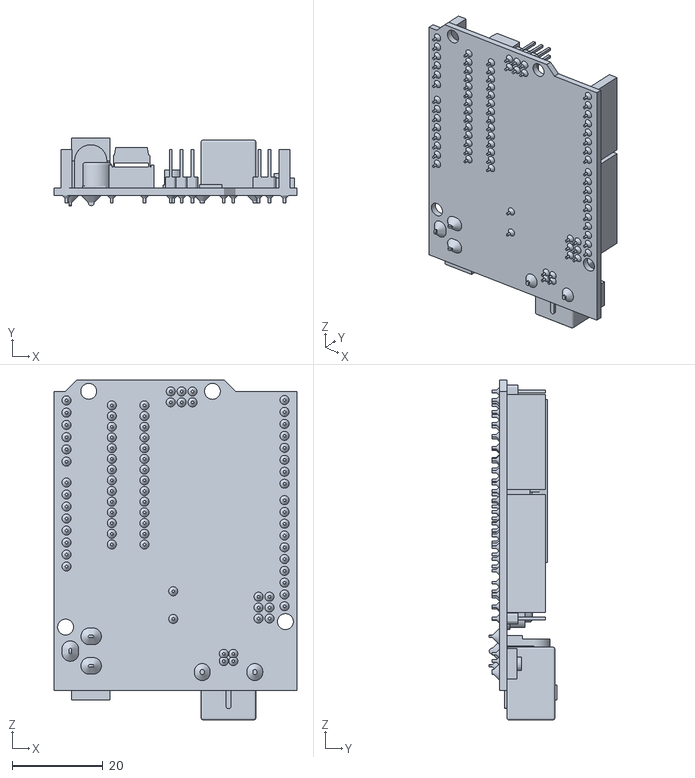
[picture p17: CAD file, 2025-06-17]
drawings/Arduino-UNO.stl
53.5 x 14.9 x 75.0
