speleoalex/opsdatalogger/drawings/box.stl

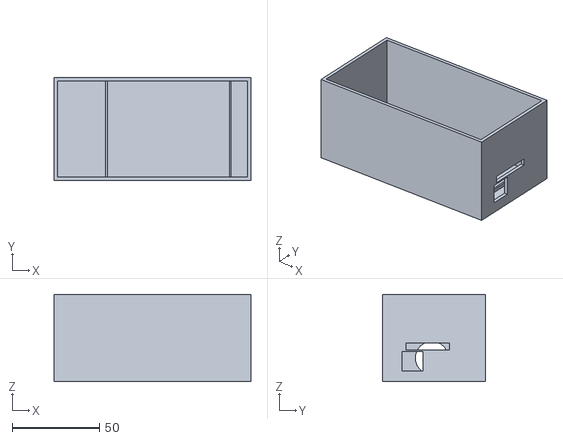
[picture p18: CAD file, 2025-06-17]
drawings/box.stl
112.8 x 58.8 x 50.0
