speleoalex/opsdatalogger/(list of files, cad)

Other CAD files:
drawings/box.dwg
