speleoalex/opsdatalogger/manuals/UpdateFirmware_it.md

# Aggiornare il firmware 

## 1. Installare l'IDE di Arduino
- Visita il Sito Web di Arduino: Vai su arduino.cc e naviga fino alla sezione di download.
- Scarica l'IDE: Seleziona la versione dell'IDE di Arduino compatibile con il tuo sistema operativo (Windows, MacOS, Linux).
- Installazione: Segui le istruzioni di installazione specifiche per il tuo sistema operativo.

## 2. Preparare l'Ambiente di Sviluppo
- Collega la Tua Arduino UNO: Usa un cavo USB per collegare la scheda Arduino UNO al tuo computer.
- Seleziona la Scheda e la Porta: Apri l'IDE di Arduino, vai su "Strumenti" > "Tipo di scheda" e seleziona "Arduino UNO". Poi, sotto "Strumenti" > "Porta", scegli la porta a cui è collegata la tua scheda.

## 3. Installare le Librerie Necessarie
 - Apri il Gestore delle Librerie: Nell'IDE di Arduino, vai su "Strumenti" > "Gestione Librerie".

- Cerca e Installa le Librerie: Cerca le librerie richieste dal tuo programma, come quelle per RTC (Real Time Clock) e scheda SD. Seleziona ciascuna libreria e clicca su "Installa".

## 4. Caricare il Programma "FluxyLogger.ino"
- Ottieni il Codice Sorgente: https://github.com/speleoalex/fluxylogger/blob/main/FluxyLogger/FluxyLogger.ino
- Apri il File nel IDE: Nell'IDE di Arduino, vai su "File" > "Apri" e seleziona il file "FluxyLogger.ino".
- Verifica e Carica il Programma: Clicca sul pulsante "Verifica" per compilare il codice. Se non ci sono errori,  clicca su "Carica" per trasferire il programma sulla tua scheda Arduino UNO.
