speleoalex/opsdatalogger/manuals/terminal.png

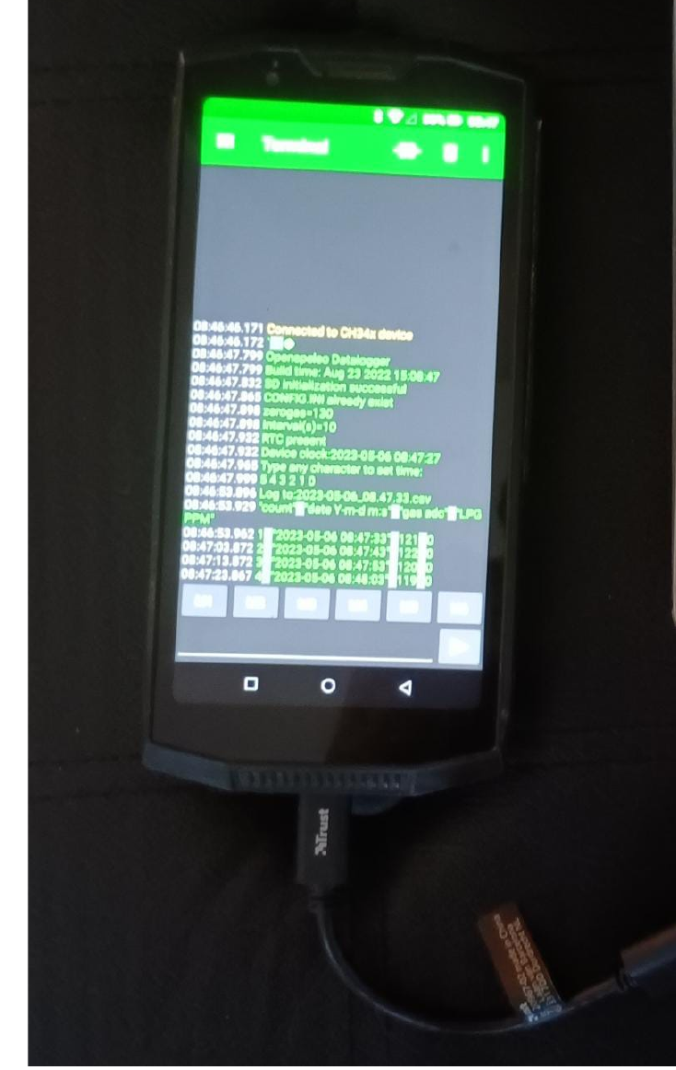
manuals/terminal.png
