speleoalex/opsdatalogger/LoggerViewer_Web/result.png

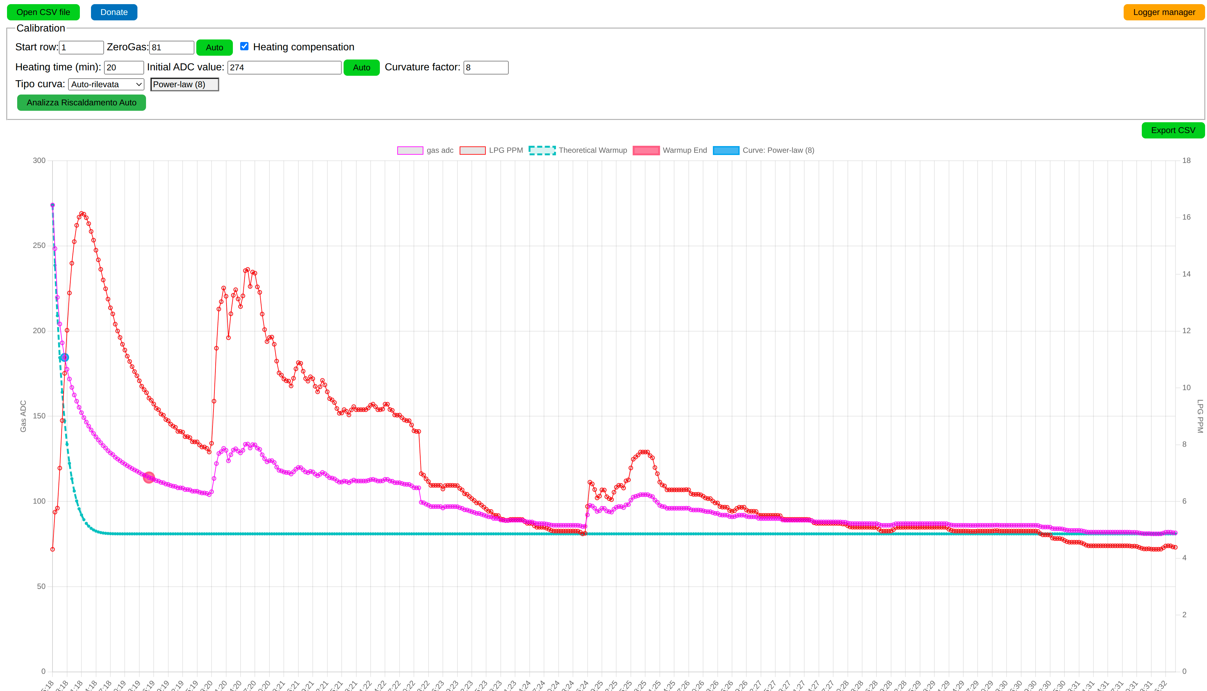
LoggerViewer_Web/result.png
