speleoalex/opsdatalogger/(commit log)

2021-09-07 added wind sensor and pressure,temperature,humidity
2021-09-07 wind sensor
2021-09-21 update sensor
2025-11-24 Reorganize repository structure with explicit directory names
    Major reorganization of the FluxyLogger repository to improve clarity and organization:
    **Directory Renames:**
    - Datalogger/ → Datalogger_TestMinimal/ (minimal test firmware for shield/RTC/SD)
    - LoggerViewer/ → LoggerViewer_Web/ (current web viewer)
    - LoggerViewer_v1/ → LoggerViewer_Web_Legacy/ (legacy web viewer)
    **Documentation Restructuring (/doc):**
    - Created subdirectories for better organization:
    - datasheets/ - Component PDFs and technical manuals
    - wiring/ - Connection schematics for all sensors
    - assembly/ - Assembly and testing procedures
    - presentations/ - Project presentation materials
    - tracers/ - At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
    [example.csv]
2025-11-24 Add assembly guides and tracer documentation
    Added comprehensive assembly documentation:
    **Assembly Guides:**
    - Created NASO_assembly_guide_it.md - Complete assembly guide for NASO configuration
    - Component list and requirements
    - Detailed wiring diagrams and tables
    - Step-by-step assembly procedure
    - Firmware loading instructions
    - Troubleshooting section
    - Maintenance guidelines
    - Created NASO_LCD_assembly_guide_it.md - Complete assembly guide for NASO+LCD configuration
    - Additional LCD display components
    - I2C wiring diagrams
    - Backlight button setup with pull-down resistor
    - LCD-specific assembly steps
    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
2025-11-24 Simplify assembly guides - sensor ventilation
    Simplified assembly instructions to be more essential:
    **Sensor Ventilation:**
    - Changed from multiple ventilation holes to simple instruction
    - Sensor must remain exposed to external air
    - Single opening for sensor to exit the box
    - More practical and easier to implement
    **Removed redundant details:**
    - Excessive steps in component positioning
    - Repeated cable management instructions
    - Over-detailed fixing procedures
    **Result:**
    - Clearer, more direct instructions
    - Focus on essential assembly steps
    - Easier to follow for users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
2025-11-24 Merge assembly guides into single comprehensive document
    Unified NASO and NASO+LCD assembly guides into one complete document:
    **New: NASO_assembly_complete_guide_it.md**
    - Combined both configurations in single guide
    - Added all wiring diagrams with image references
    - Clear separation between base and LCD configurations
    - Comprehensive component lists with tables
    - Step-by-step assembly for both versions
    **Key improvements:**
    - Marked button as optional (backlight control)
    - Added note: without button, backlight always on
    - Included all connection schemas (MQ-2, LCD I2C)
    - Side-by-side comparison of specifications
    - Unified troubleshooting section
    - Complete maintenance guidelines
    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
2025-11-24 Fix button wiring - direct 5V connection, internal pull-up
    Corrected button connection schema:
    **Previous (incorrect):**
    - Button between D8 and GND
    - External 10kΩ pull-down resistor required
    **Current (correct):**
    - Button between +5V and D8
    - Internal pull-up activated in firmware
    - No external resistor needed
    **Changes:**
    - Removed resistor from component list
    - Updated connection tables (Pin 1: +5V, Pin 2: D8)
    - Updated wiring schema ASCII art
    - Added technical note about internal pull-up
    - Updated verification checklist
    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
2025-11-24 Add METEO and VOC assembly guide
    Created minimal but complete assembly documentation for METEO and VOC configurations:
    **METEO Configuration:**
    - BMP280 sensor (pressure, temperature) at 3.3V
    - Anemometer sensor (wind speed) at 5V
    - Connection tables and wiring diagrams
    - Example initialization code
    **VOC Configuration:**
    - SGP40 sensor (air quality, VOC)
    - Optional LCD display
    - I2C multi-device setup explained
    - Connection tables and example code
    **Features:**
    - Voltage warnings (BMP280 = 3.3V critical)
    - I2C address documentation
    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
2025-11-24 Merge testing procedures into assembly guides
    Consolidated testing procedures directly into assembly guides for simpler, more essential documentation:
    - Removed separate testing procedure files (NASO_testing_procedure_it.md, NASO_testing_procedure_en.md)
    - Integrated testing steps into NASO_assembly_complete_guide_it.md
    - Integrated testing steps into METEO_VOC_assembly_guide_it.md
    - Simplified format: removed numbered lists, using bold headers with bullet points
    - Updated doc/README.md to reflect new structure
    - Single comprehensive guide per configuration (assembly + testing)
    - Minimal, essential, practical instructions
    - No redundant files or cross-references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
2025-11-24 Add English translations of assembly guides and update cross-references
    Created complete English translations and improved documentation structure:
    **New Files:**
    - doc/assembly/NASO_assembly_complete_guide_en.md - English translation of NASO/NASO+LCD assembly guide
    - doc/assembly/METEO_VOC_assembly_guide_en.md - English translation of METEO/VOC assembly guide
    **Updated Files:**
    - doc/README.md - Added bilingual structure with IT/EN sections
    - doc/assembly/NASO_assembly_complete_guide_it.md - Added comprehensive cross-references
    - doc/assembly/METEO_VOC_assembly_guide_it.md - Added comprehensive cross-references
    - doc/assembly/NASO_assembly_complete_guide_en.md - Added comprehensive cross-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
2025-11-24 Update METEO/VOC firmware documentation based on code analysis
    Analyzed FluxyLogger.ino v2.45 firmware and updated documentation to reflect actual implementation status:
    **Key Findings:**
    - ✅ METEO support (BMP280, Anemometer) is COMPLETE but disabled by default
    - ✅ VOC support (SGP40, SGP30) is COMPLETE but disabled by default
    - ✅ All sensor code, initialization, data reading, and CSV headers already implemented
    - ✅ Libraries included in firmware (farmerkeith_BMP280, SparkFun_SGP40)
    **Documentation Updates:**
    - BMP280: Line 24 `#define BMP280_PRESENT 0` → change to 1
    - Anemometer: Line 33 `#define WINDSENSOR_PRESENT 0` → change to 1
    - Complete impleme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
2025-11-24 Update README with METEO/VOC firmware status and documentation links
    Updated main README.md to reflect current project status:
    **Available Configurations Table:**
    - Added "Status" column with visual indicators
    - ✅ NASO/NASO+LCD: Ready (production status)
    - ✅ METEO: Firmware ready (BMP280 + Anemometer)
    - ✅ VOC: Firmware ready (SGP40/SGP30)
    - Updated documentation links to new assembly guides
    - Added note about firmware v2.45 having complete support
    **Documentation Section:**
    - Added new "Assembly Guides" subsection with IT/EN links
    - Updated Technical Documentation links
    - Added firmware version number (v2.45)
    - Improved organization with clearer sections
    **Data Format Section:**
    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
2025-11-24 Update repository URLs from opsdatalogger to fluxylogger
    Updated all GitHub repository references across documentation files
    to reflect the repository rename from opsdatalogger to fluxylogger.
    This includes updates to README, platform overviews, assembly guides,
    manuals, and project history files.
